scattercat-123/VoidLens-DIY-VR-Headset/CAD/VoidLens DIY VR Headset.step

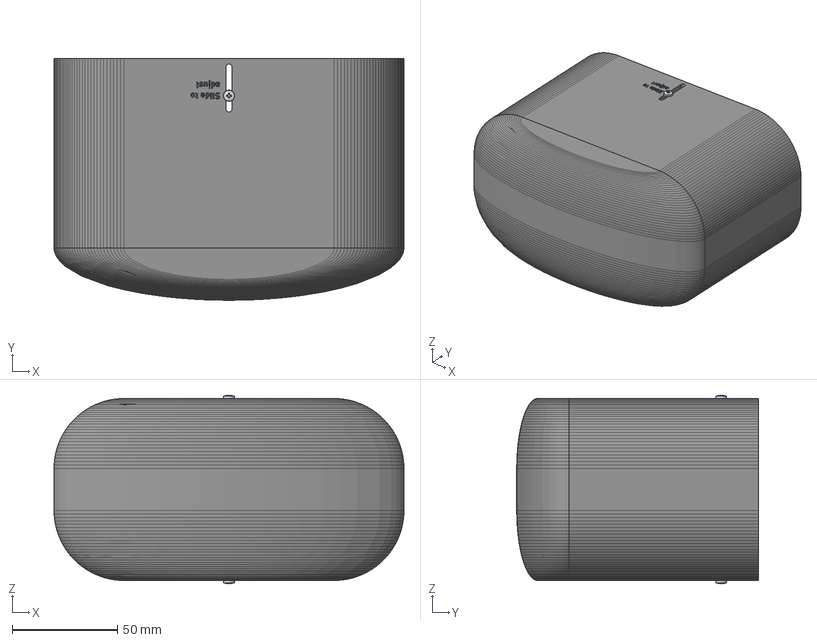
[picture p1: CAD file, 2026-05-26]
CAD/VoidLens DIY VR Headset.step
166.6 x 115.0 x 89.7 mm
Display 1
Display 2
BI M3x3
BHSBHCS ASME B18.3.4M - M3 x 0.5 x 6 Steel Grade 2 Plain x 2
BHS JIS B 1111 - M2.5x8 Steel 4.6 Plain x 2
BI M3x3_1
