scattercat-123/VoidLens-DIY-VR-Headset/PCB/VoidLens PCB.pdf

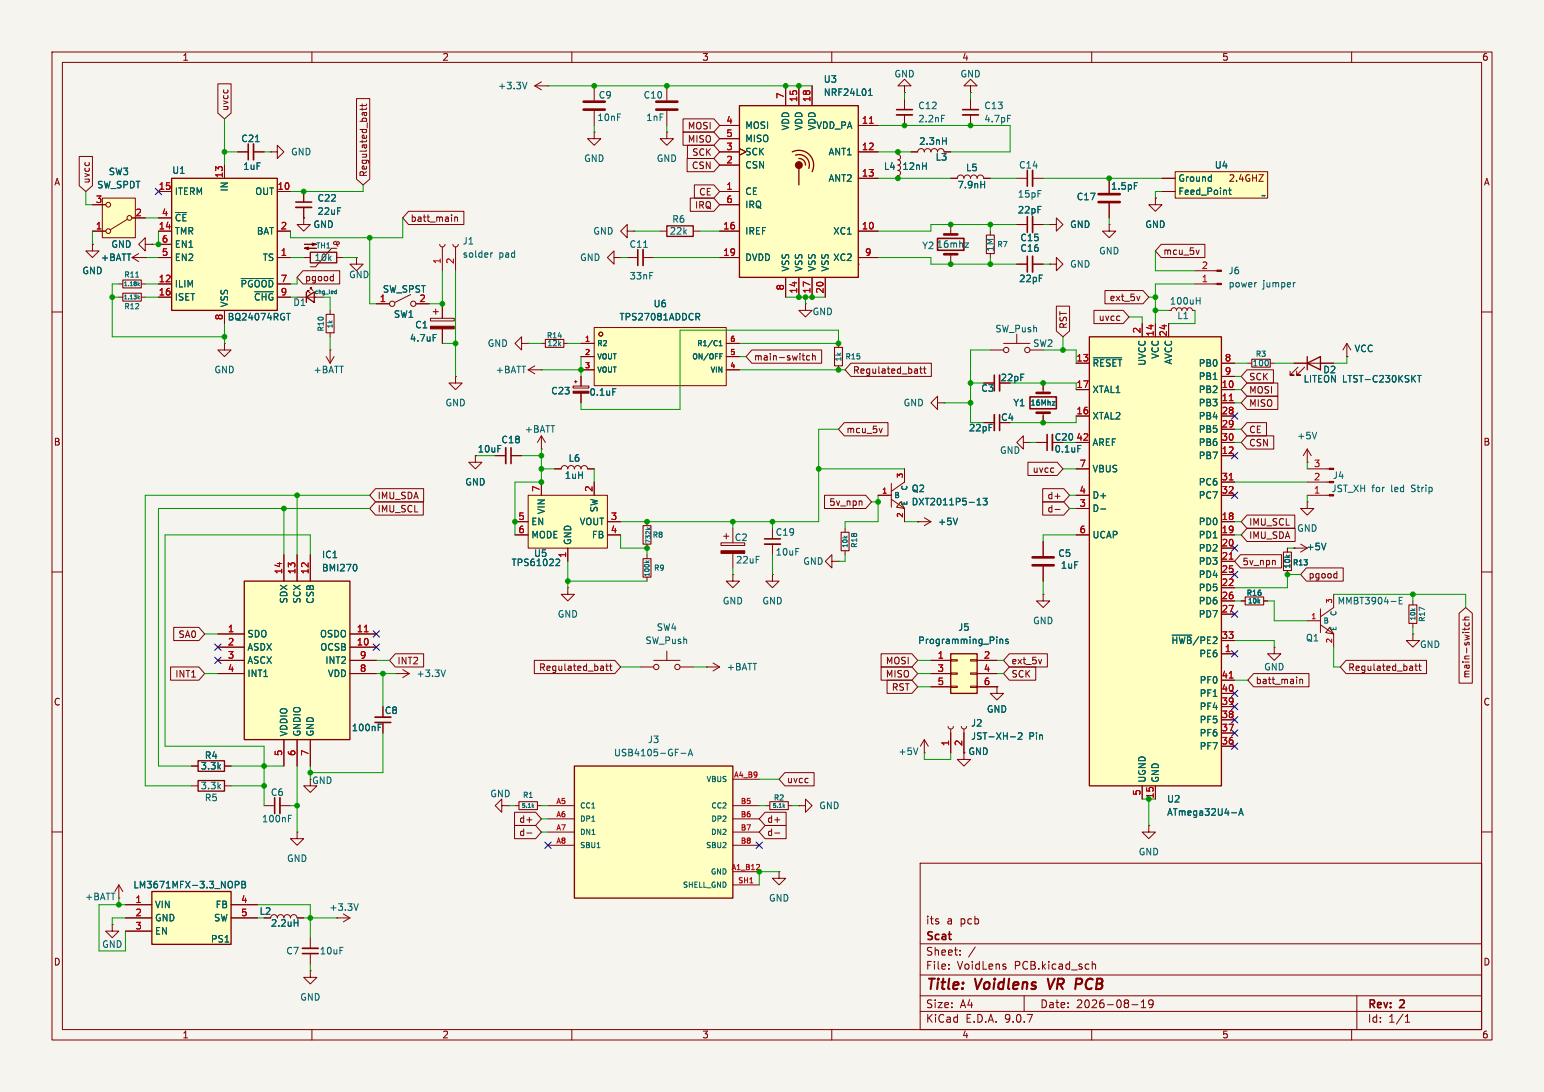
[picture p2: page 1]

8 VDD 15 VSS 14 VDD 18 VSS 17 VSS 20 VDD_PA 11 ANT1 12 ANT2 13 XC1 10 XC2 9 U3 NRF24L01 R6

8 VDD 15 VSS 14 VDD 18 VSS 17 VSS 20 VDD_PA 11 ANT1 12 ANT2 13 XC1 10 XC2 9 U6 TPS27081ADDCR

8 OUT 10 BAT 2 TS 1 ~{PGOOD}7 ~{CHG}9 U1 BQ24074RGT
ITERM 15 ~{CE} 4 TMR 14 EN1 6 EN2 5

8 OUT 10 BAT 2 TS 1 ~{PGOOD}7 ~{CHG}9 U2ATmega32U4-A

2 VOUT 3 FB 4 U5 TPS61022 GND GND

5 VCC 14 GND 15 AVCC 24 PB0 8 PB1 9 PB2 10 PB3 11 PB4 28 PB5 29 PB6 30 PB7 12 PC6 31 PC7 32 PD0 18 PD1 19 PD2 20 PD3 21 PD4 25 PD5 22 PD6 26 PD7 27 ~{HWB}/PE233 PE6 1 PF0 41 PF1 40 PF4 39 PF5 38 PF6 37 PF7 36 C5

5 VCC 14 GND 15 AVCC 24 PB0 8 PB1 9 PB2 10 PB3 11 PB4 28 PB5 29 PB6 30 PB7 12 PC6 31 PC7 32 PD0 18 PD1 19 PD2 20 PD3 21 PD4 25 PD5 22 PD6 26 PD7 27 ~{HWB}/PE233 PE6 1 PF0 41 PF1 40 PF4 39 PF5 38 PF6 37 PF7 36 U2ATmega32U4-A

Id: 1/1 Title: Voidlens VR PCB
