scattercat-123/VoidLens-DIY-VR-Headset/PCB/VoidLens PCB.kicad_sch

## KiCad design PCB/VoidLens PCB.kicad_sch (2026-08-30, an earlier design)

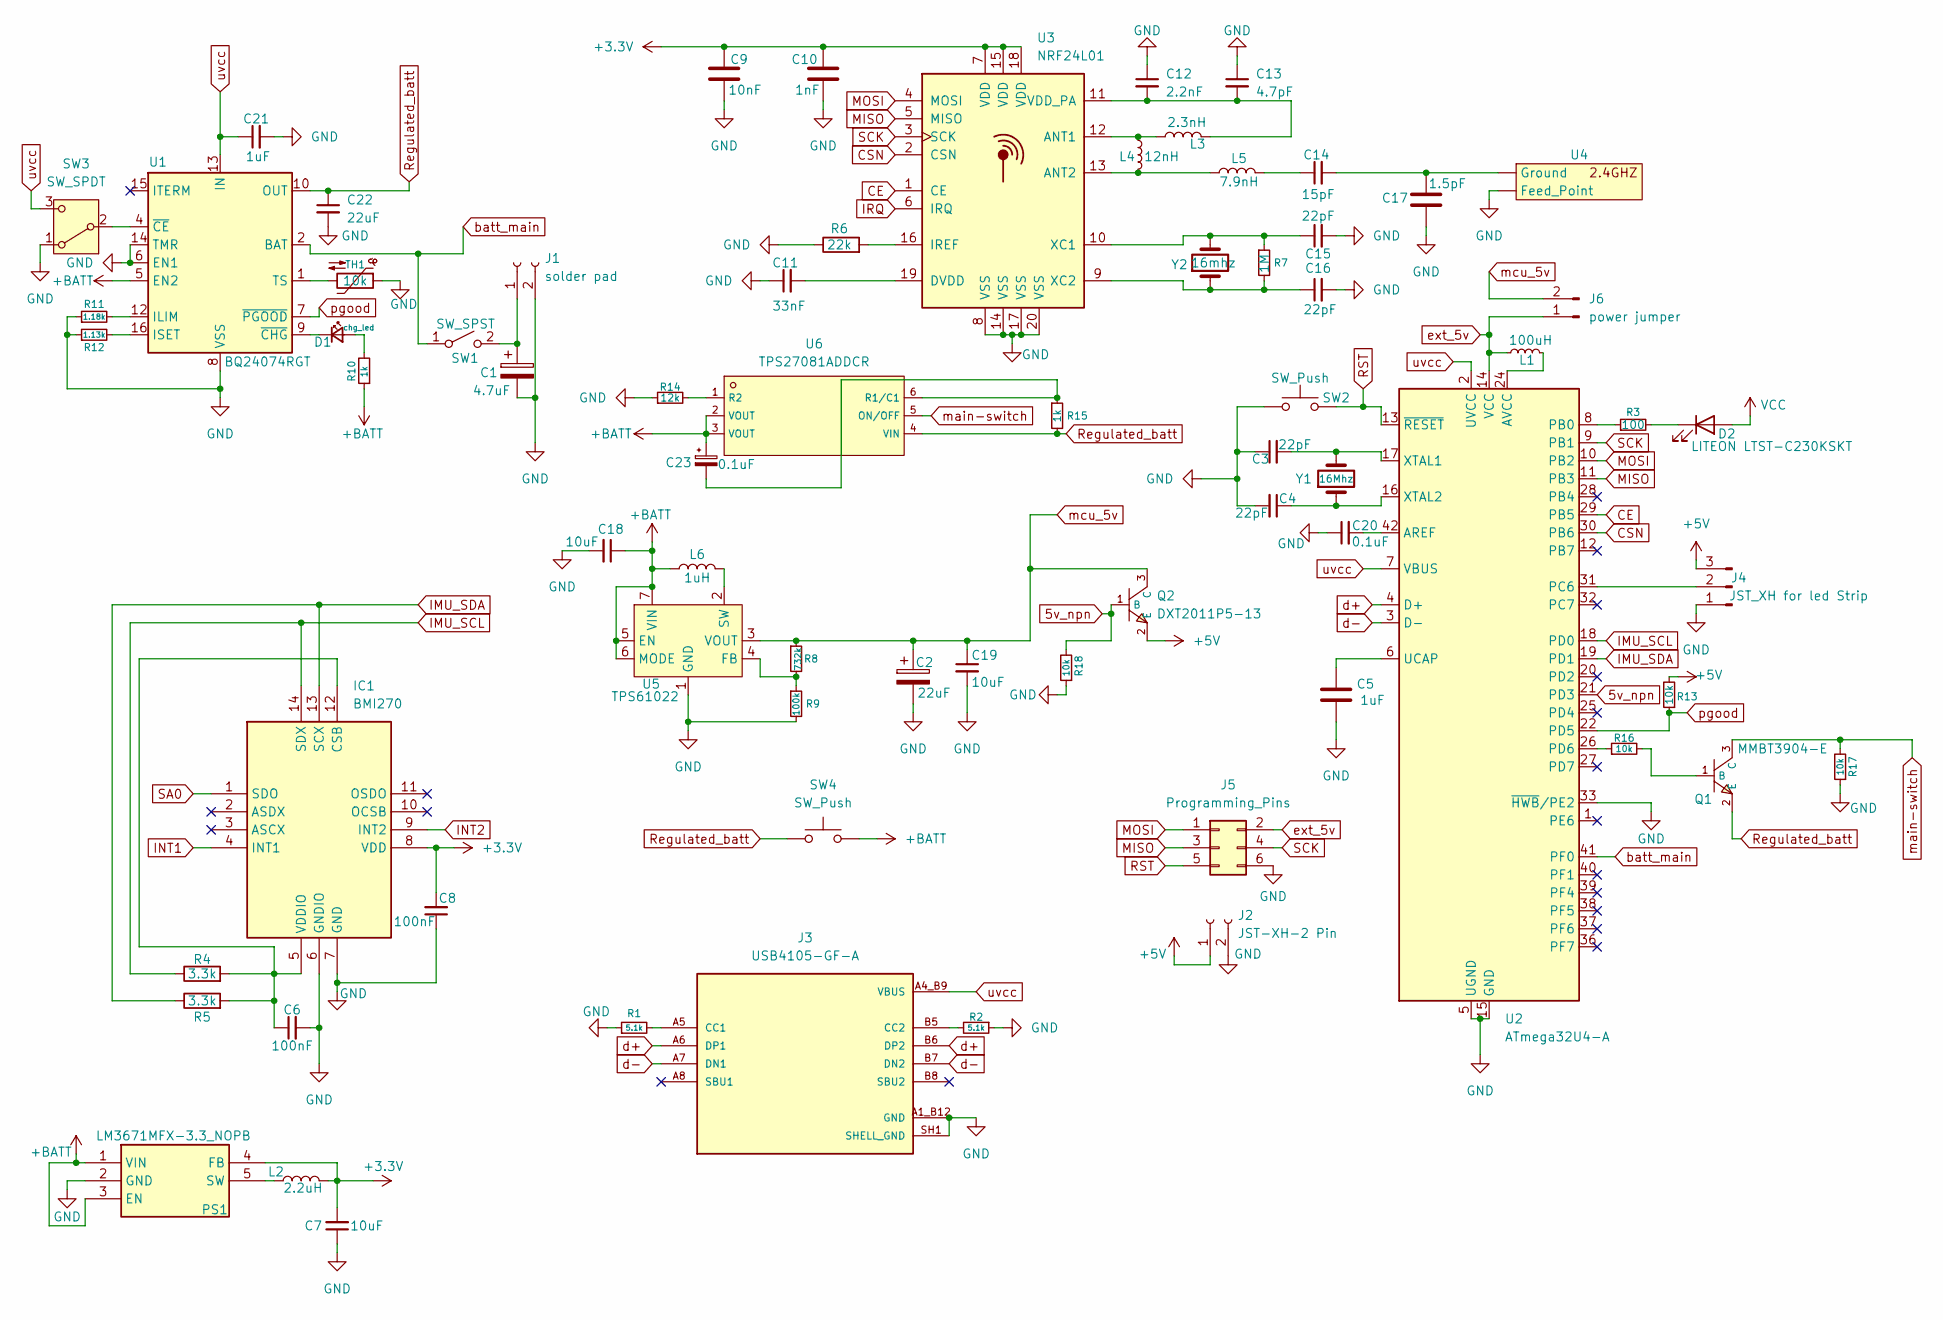
[picture p3: schematic VoidLens PCB.kicad_sch]

Parts:
C1: 4.7uF; CP_Elec_4x5.4
C2: 22uF; CP_Elec_4x5.4
C3, C4, C15, C16: 22pF; C_0603_1608Metric_Pad1.08x0.95mm_HandSolder
C5, C21: 1uF; C_0603_1608Metric_Pad1.08x0.95mm_HandSolder
C6, C8: 100nF; C_0603_1608Metric_Pad1.08x0.95mm_HandSolder
C7, C18, C19: 10uF; C_0603_1608Metric_Pad1.08x0.95mm_HandSolder
C9: 10nF; C_0603_1608Metric_Pad1.08x0.95mm_HandSolder
C10: 1nF; C_0603_1608Metric_Pad1.08x0.95mm_HandSolder
C11: 33nF; C_0603_1608Metric_Pad1.08x0.95mm_HandSolder
C12: 2.2nF; C_0603_1608Metric_Pad1.08x0.95mm_HandSolder
C13: 4.7pF; C_0603_1608Metric_Pad1.08x0.95mm_HandSolder
C14: 15pF; C_0603_1608Metric_Pad1.08x0.95mm_HandSolder
C17: 1.5pF; C_0603_1608Metric_Pad1.08x0.95mm_HandSolder
C20, C23: 0.1uF
C22: 22uF; C_0603_1608Metric_Pad1.08x0.95mm_HandSolder
D1: chg_led
D2: LITEON LTST-C230KSKT
IC1: BMI270; Manufacturer_Part_Number BMI270; Mouser Part Number 262-BMI270
J1: solder pad
J2: JST-XH-2 Pin
J3: USB4105-GF-A; GCT_USB4105-GF-A; PARTREV B4
J4: JST_XH for led Strip
J5: Programming_Pins
J6: power jumper
L1: 100uH
L2: 2.2uH
L3: 2.3nH
L4: 12nH
L5: 7.9nH
L6: 1uH
PS1: LM3671MFX-3.3_NOPB; Manufacturer_Part_Number LM3671MFX-3.3/NOPB; Mouser Part Number 926-LM3671MFX33NOPB
Q1: MMBT3904-E; C41371422_SOT-23-3_L2_9-W1_4-P1_90-LS2_5-BR; LCSC C41371422
Q2: DXT2011P5-13; C155259_POWERDI-5_L5_4-W4_0-LS6_5-RD; LCSC C155259
R1, R2: 5.1k
R3: 100
R4, R5: 3.3k
R6: 22k
R7: 1M
R8: 732k
R9: 100k
R10, R15: 1k
R11: 1.18k
R12: 1.13k
R13, R16, R17, R18: 10k
R14: 12k
SW1: SW_SPST
SW2, SW4: SW_Push
SW3: SW_SPDT
TH1: 10k
U1: BQ24074RGT; VQFN-16-1EP_3x3mm_P0.5mm_EP1.6x1.6mm
U2: ATmega32U4-A; TQFP-44_10x10mm_P0.8mm
U3: NRF24L01; QFN-20-1EP_4x4mm_P0.5mm_EP2.5x2.5mm
U4: (no value)
U5: TPS61022; Texas_RWU0007A_VQFN-7_2x2mm_P0.5mm
U6: TPS27081ADDCR; C128404_SOT-23-6_L2_9-W1_6-P0_95-LS2_8-BR; LCSC C128404
Y1: 16Mhz
Y2: 16mhz

Connections:
5v_npn: Q2.1 (B), R18.2, U2.21 (PD3)
+3.3V: C7.2, C8.2, C9.1, C10.1, IC1.8 (VDD), L2.2, PS1.4 (FB), U3.7 (VDD), U3.15 (VDD), U3.18 (VDD)
+5V: J2.1, J4.3, Q2.2 (E), R13.2
+BATT: C18.1, C23.1, L6.1, PS1.1 (VIN), PS1.3 (EN), R10.1, SW4.2, U1.5 (EN2), U5.5 (EN), U5.6 (MODE), U5.7 (VIN), U6.2 (VOUT), U6.3 (VOUT)
CE: U2.29 (PB5), U3.1 (CE)
CSN: U2.30 (PB6), U3.2 (CSN)
GND: C1.2, C2.2, C3.1, C4.2, C5.2, C6.2, C7.1, C8.1, C9.2, C10.2, C11.1, C12.1, C13.1, C15.2, C16.2, C17.2, C18.2, C19.2, C20.1, C21.2, C22.2, IC1.6 (GNDIO), IC1.7 (GND), J1.2, J2.2, J3.A1_B12 (GND), J3.B1_A12 (GND), J3.SH1 (SHELL_GND), J3.SH2 (SHELL_GND), J3.SH3 (SHELL_GND), J3.SH4 (SHELL_GND), J4.1, J5.6, PS1.2 (GND), R1.1, R2.1, R6.1, R9.2, R11.1, R12.1, R14.1, R17.1, R18.1, SW2.1, SW3.1 (A), TH1.1, U1.6 (EN1), U1.8 (VSS), U1.14 (TMR), U1.17 (VSS), U2.5 (UGND), U2.15 (GND), U2.23 (GND), U2.33 (~HWB/PE2), U2.35 (GND), U2.43 (GND), U3.8 (VSS), U3.14 (VSS), U3.17 (VSS), U3.20 (VSS), U4., U5.1 (GND)
IMU_SCL: IC1.14 (SDX), R4.1, U2.18 (PD0)
IMU_SDA: IC1.13 (SCX), R5.1, U2.19 (PD1)
INT1: IC1.4 (INT1)
INT2: IC1.9 (INT2)
IRQ: U3.6 (IRQ)
MISO: J5.3, U2.11 (PB3), U3.5 (MISO)
MOSI: J5.1, U2.10 (PB2), U3.4 (MOSI)
unnamed: C1.1, J1.1, SW1.2 (B)
unnamed: C3.2, U2.17 (XTAL1), Y1.2
unnamed: C4.1, U2.16 (XTAL2), Y1.1
unnamed: C5.1, U2.6 (UCAP)
unnamed: C6.1, IC1.5 (VDDIO), IC1.12 (CSB), R4.2, R5.2
unnamed: C11.2, U3.19 (DVDD)
unnamed: C12.2, C13.2, L3.2, U3.11 (VDD_PA)
unnamed: C14.1, L5.2
unnamed: C14.2, C17.1, U4.
unnamed: C15.1, R7.1, U3.10 (XC1), Y2.2
unnamed: C16.1, R7.2, U3.9 (XC2), Y2.1
unnamed: C20.2, U2.42 (AREF)
unnamed: C23.2, R15.1, U6.6 (R1/C1)
unnamed: D1.1 (K), U1.9 (~CHG)
unnamed: D1.2 (A), R10.2
unnamed: D2.1 (K), R3.2
unnamed: J3.A5 (CC1), R1.2
unnamed: J3.B5 (CC2), R2.2
unnamed: J4.2, U2.31 (PC6)
unnamed: L1.2, U2.24 (AVCC), U2.44 (AVCC)
unnamed: L2.1, PS1.5 (SW)
unnamed: L3.1, L4.1, U3.12 (ANT1)
unnamed: L4.2, L5.1, U3.13 (ANT2)
unnamed: L6.2, U5.2 (SW)
unnamed: Q1.1 (B), R16.2
unnamed: R3.1, U2.8 (PB0)
unnamed: R6.2, U3.16 (IREF)
unnamed: R8.2, R9.1, U5.4 (FB)
unnamed: R11.2, U1.12 (ILIM)
unnamed: R12.2, U1.16 (ISET)
unnamed: R14.2, U6.1 (R2)
unnamed: R16.1, U2.26 (PD6)
unnamed: SW3.2 (B), U1.4 (~CE)
unnamed: TH1.2, U1.1 (TS)
RST: J5.5, SW2.2, U2.13 (~RESET)
Regulated_batt: C22.1, Q1.2 (E), R15.2, SW4.1, U1.10 (OUT), U1.11 (OUT), U6.4 (VIN)
SA0: IC1.1 (SDO)
SCK: J5.4, U2.9 (PB1), U3.3 (SCK)
VCC: D2.2 (A)
batt_main: SW1.1 (A), U1.2 (BAT), U1.3 (BAT), U2.41 (PF0)
d+: J3.A6 (DP1), J3.B6 (DP2), U2.4 (D+)
d-: J3.A7 (DN1), J3.B7 (DN2), U2.3 (D-)
ext_5v: J5.2, J6.1, L1.1, U2.14 (VCC), U2.34 (VCC)
main-switch: Q1.3 (C), R17.2, U6.5 (ON/OFF)
mcu_5v: C2.1, C19.1, J6.2, Q2.3 (C), R8.1, U5.3 (VOUT)
pgood: R13.1, U1.7 (~PGOOD), U2.22 (PD5)
uvcc: C21.1, J3.A4_B9 (VBUS), J3.B4_A9 (VBUS), SW3.3 (C), U1.13 (IN), U2.2 (UVCC), U2.7 (VBUS)
