scattercat-123/VoidLens-DIY-VR-Headset/JOURNAL.md

---
title: "VoidLens DIY VR Headset Revision"
author: "Atharv Sharma(scattercat_123)"
description: "A DIY VR Headset which works with SteamVR and is pretty high quality!"
created_at: "2026-05-25"
---

# May 25th: Made Basic CAD and researched about design!

So Basically my older Voidlens VR Headset I made for Highway was pretty good but the design wasnt bad or modular, it could only fit my shape and pcb had many errors i dint consider, now that i have all the parts im doing a redesign and make it look cool so that anyon in the world can mak their own vr headset for free and DIY. Today, I made the lens holders proper because my last design had many defect such as the lens was protuded out a bit which is bad and there were clips holding in plae instead of a press fit whcih now makes it repairable instead of like a permanent thing. I also added Adjustable like focal length thingy so that i can adjust it to my comfort instead of doing trial and error until it fits, it also anbles other people to lik etry other diameter/focal lenses. Secondly i made it look less boxier and ugly like the old one add added like hidden screw stuff im still working on it though. You can check it out below!



<b>Layers of the headset</b>



<b>Final Headset</b>



<b>A Peak on how the adjustable thingy works</b>

**Total time spent: 2h 9m**

# May 28th: More CAD!

Today I did more of the CAD not a lot and i logged my gtihub jounral and also like measured my battery

# May 29th: Started PCB and added magnet fittings to the cad

Basically i added magnetic fittings:


I will be like pausing the print putting the magnets and resuimng again o that magnets tay in place thsi doesnt leve any screw holes and  doesnt make it ugly like the  last design. intead its more satisfying.

After i started the pcb dsign, My oroginal plan was to use the 3S Lipo battery but Lion's would be more effiecient and safe, firstly i did probably like a 30-45 min research on how do i design my own LDO but at the end i figured out it wouldnt work since the max voltage of 2S Lion is like 8.4 and if the ldo has to do a 3.4v dropput its very enefficient and makes the cicuit more hot. BTW i found this mh118650 lg batteries from and old power bank which doesnt work anymore but the batteries are pretty healthy!

Then i had to make a bck converter circuit which was pretty easy and then i also did most of the pcb:


So thats it.

**Total time spent: About 2h**
