scattercat-123/VoidLens-DIY-VR-Headset/(commit log)

2026-05-26 Basic cad
    [VoidLens DIY VR Headset.step]
2026-05-28 Add journal entry for VoidLens DIY VR headset revision
    Documented the design process and improvements for the VoidLens DIY VR headset, including CAD work and adjustments for modularity and comfort.
2026-05-29 Revise journal entries for May 28th and 29th
    Updated journal entries with details on CAD work, PCB design, and battery research.
2026-08-25 finished pcb schematic
    [VoidLens PCB.kicad_pcb, VoidLens PCB.kicad_sch]
2026-08-25 rearrange files
    [VoidLens PCB.kicad_pcb, VoidLens PCB.kicad_sch]
2026-08-30 assigned some more footprints
    [VoidLens PCB.kicad_sch]
